giunzz/IoT_AquaNova/Thamkhao/CSS_HTML_JS_Smart City/WEB/lab1/bautroi.jpg

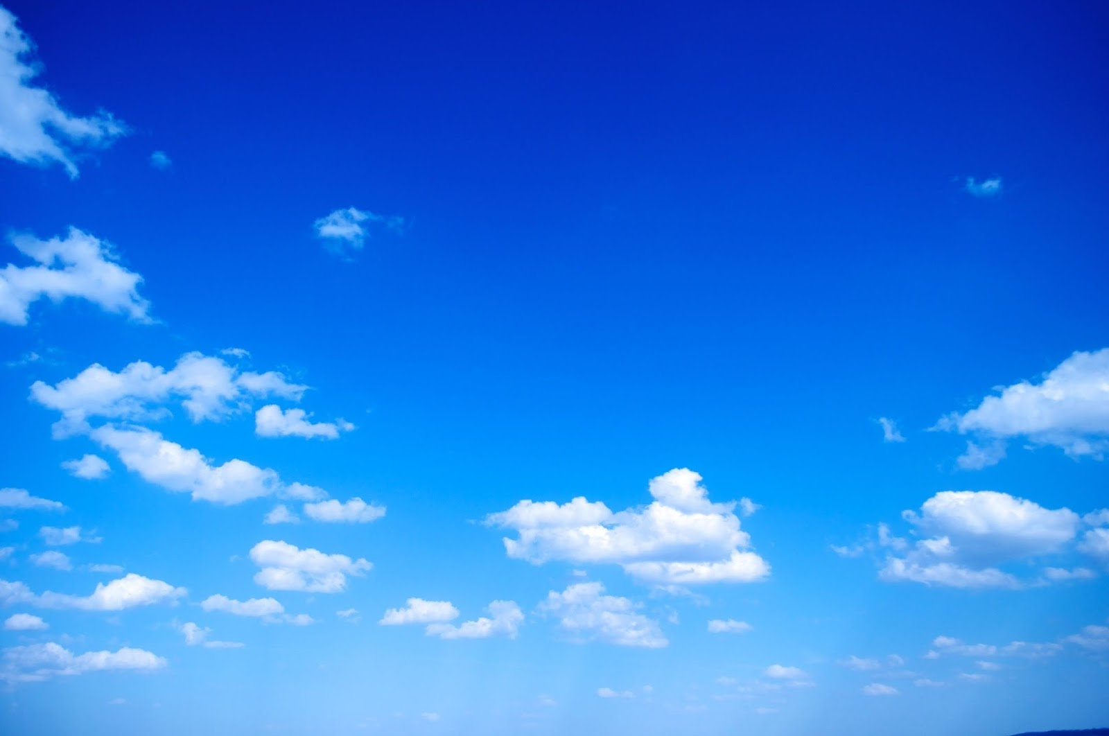
Thamkhao/CSS_HTML_JS_Smart City/WEB/lab1/bautroi.jpg
