giunzz/IoT_AquaNova/Thamkhao/CSS_HTML_JS_Smart City/WEB/lab1/den1.png

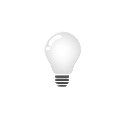
Thamkhao/CSS_HTML_JS_Smart City/WEB/lab1/den1.png
