giunzz/IoT_AquaNova/Thamkhao/CSS_HTML_JS_Smart City/WEB/lab1/image/doam1.png

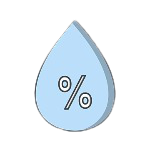
Thamkhao/CSS_HTML_JS_Smart City/WEB/lab1/image/doam1.png
