giunzz/IoT_AquaNova/Thamkhao/CSS_HTML_JS_Smart City/WEB/lab1/image/doam.jpg

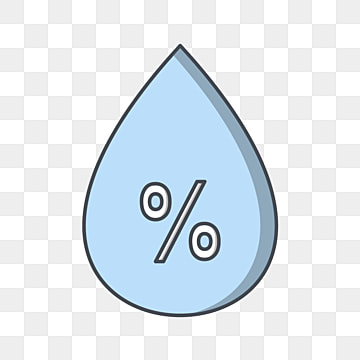
Thamkhao/CSS_HTML_JS_Smart City/WEB/lab1/image/doam.jpg
