giunzz/IoT_AquaNova/Thamkhao/CSS_HTML_JS_Smart City/WEB/lab1/main1.jpeg

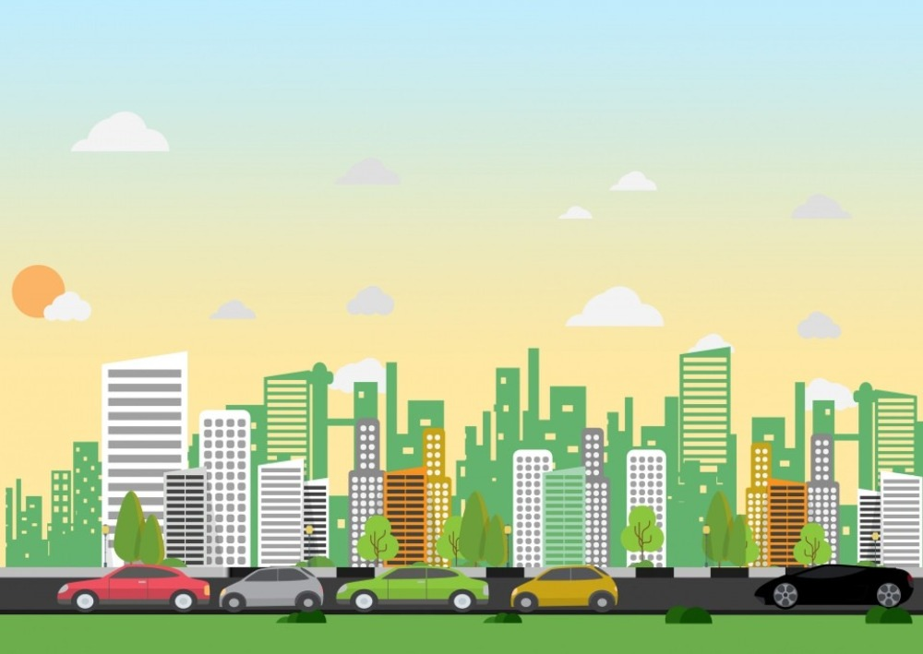
Thamkhao/CSS_HTML_JS_Smart City/WEB/lab1/main1.jpeg
