giunzz/IoT_AquaNova/MCU/Core/Inc/main.h

#define LED_Pin GPIO_PIN_13
#define LED_GPIO_Port GPIOC
#define TURB_Pin GPIO_PIN_1
#define TURB_GPIO_Port GPIOA
#define ECHO_Pin GPIO_PIN_4
#define ECHO_GPIO_Port GPIOA
#define TRIG_HCSR04_Pin GPIO_PIN_5
#define TRIG_HCSR04_GPIO_Port GPIOA
#define BUZZER_Pin GPIO_PIN_6
#define BUZZER_GPIO_Port GPIOA
#define LIGHT_Pin GPIO_PIN_7
#define LIGHT_GPIO_Port GPIOA
#define ALARM_Pin GPIO_PIN_1
#define ALARM_GPIO_Port GPIOB
#define ALARM_EXTI_IRQn EXTI1_IRQn
#define DS18B20_Pin GPIO_PIN_15
#define DS18B20_GPIO_Port GPIOB
#define BUTTON_OFF_Pin GPIO_PIN_15
#define BUTTON_OFF_GPIO_Port GPIOA
#define BUTTON_OFF_EXTI_IRQn EXTI15_10_IRQn
#define BUTTON_CONTROL_Pin GPIO_PIN_3
#define BUTTON_CONTROL_GPIO_Port GPIOB
#define BUTTON_CONTROL_EXTI_IRQn EXTI3_IRQn
#define BUTTON_DOWN_Pin GPIO_PIN_4
#define BUTTON_DOWN_GPIO_Port GPIOB
#define BUTTON_DOWN_EXTI_IRQn EXTI4_IRQn
#define BUTTON_UP_Pin GPIO_PIN_5
#define BUTTON_UP_GPIO_Port GPIOB
#define BUTTON_UP_EXTI_IRQn EXTI9_5_IRQn
#define BUTTON_Pin GPIO_PIN_8
#define BUTTON_GPIO_Port GPIOB
#define BUTTON_EXTI_IRQn EXTI9_5_IRQn
#define SERVO_Pin GPIO_PIN_9
#define SERVO_GPIO_Port GPIOB
