giunzz/IoT_AquaNova/(commit log)

2025-09-22 update feed timer (set schedule)
2025-10-16 update push subscriber
    fix feedtimer.html
    [Final_Project.ioc, main.c]
2025-10-16 update esp uart
2025-10-17 update fix code firebase and feed timer
2025-10-20 update new version
    hiệu chỉnh cảm biến
2025-10-27 update esp32
2025-10-30 Revert "update esp32"
    This reverts commit 4a2c19964c1e5775114a06b98d362566ed873e8b.
2025-11-25 mẫu
2025-12-20 update stm32
